eltradec/SCSI2SD-Mod/creator/readme

The BUILD command takes around 1-2 minutes to execute, it finishes with 4 warnings and the message below.
Der BUILD Befehl braucht etwa 1-2 Minuten zur Ausführung, er endet mit 4 Warnungen und der folgenden Meldung.

Flash used: 88334 of 262144 bytes (33,7%). Bootloader: 17152 bytes. Application: 70926 bytes. Metadata: 256 bytes.
SRAM used: 23589 of 65536 bytes (36,0%). Stack: 4096 bytes. Heap: 1024 bytes.

Sound output is generated by interrupts. The source code for the interrupt service routine is contained in the Generated_Source folder.
You need to build your project first, replace SOUND_ISR.c and SOUND_ISR.h by the files contained here in Generated_Source folder and rebuild.
Special instructions prevent PSoC Creator from overwriting these modified files.
Die Tonausgabe ist interruptgesteuert. Der Quellcode für die Interruproutine befindet sich im Ordner Generated_Source.
Sie sollten zuerst das Projekt normal kompilieren (BUILD), die generierten SOUND_ISR.c und SOUND_ISR.h durch die beiden gleichnamigen Files aus dem Ordner Generated_Source hier auf Github ersetzen und nochmals kompilieren (BUILD).
Spezielle Befehle verhindern, dass PSoC Creator diese modifizierten Files überschreibt.
