eltradec/SCSI2SD-Mod/kicad/scsi2sdkit11.pdf

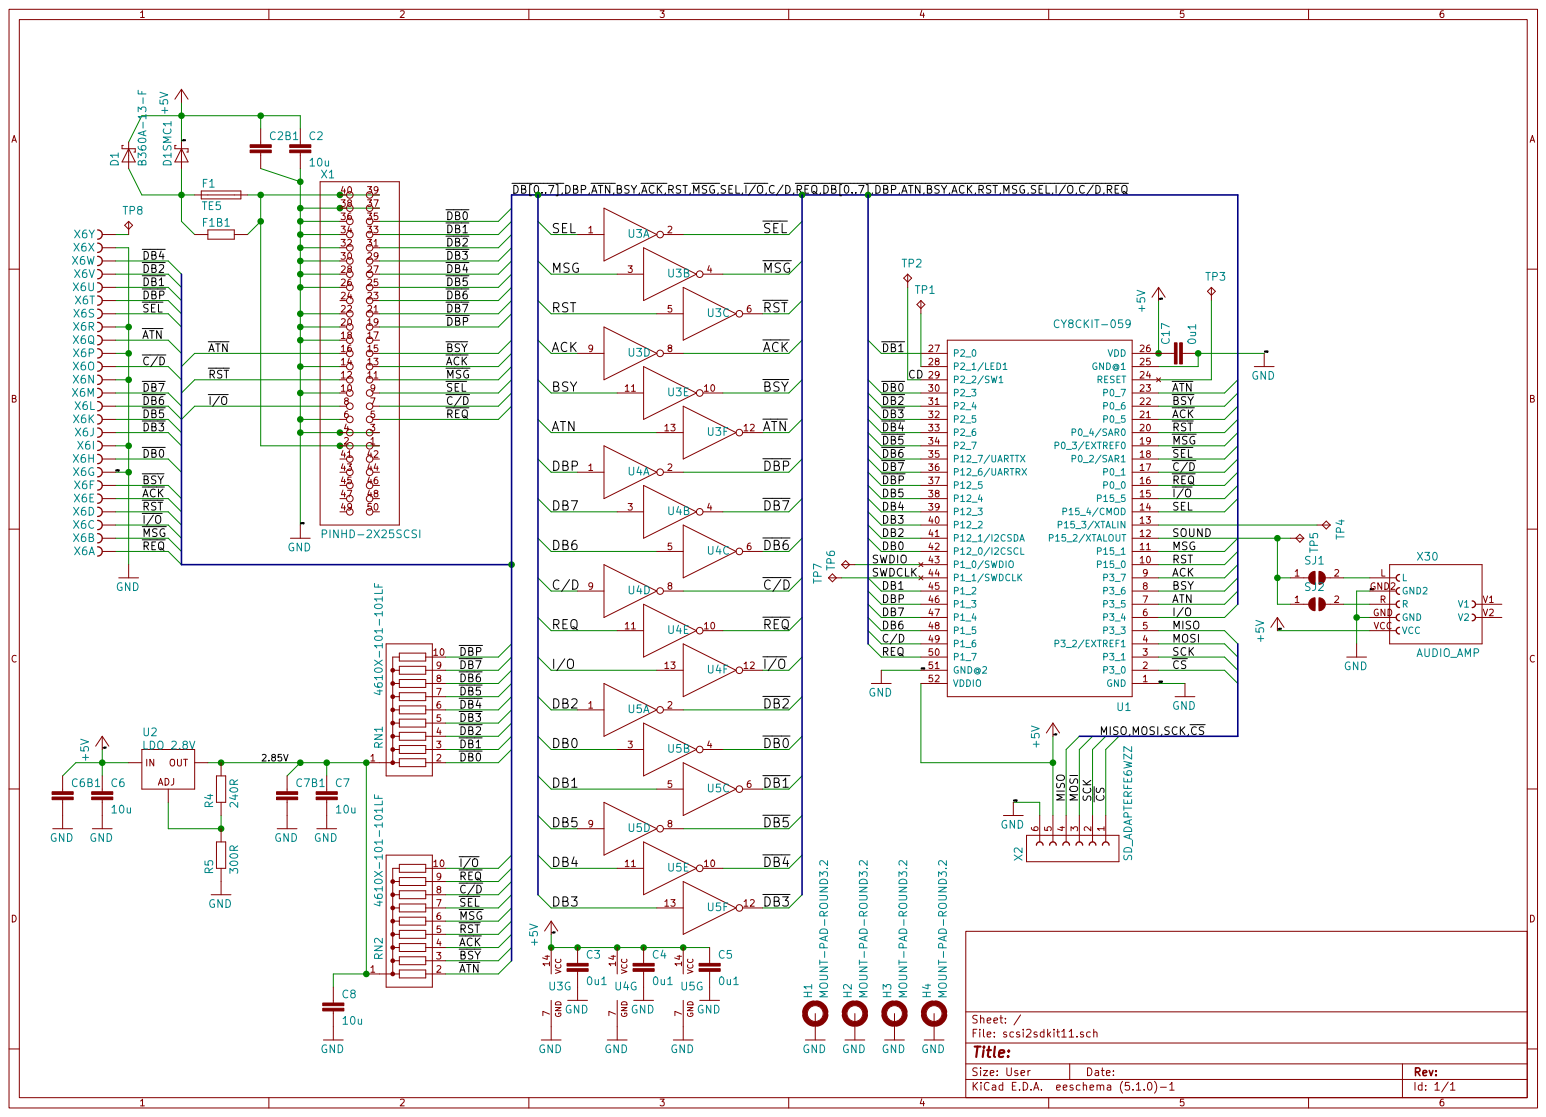
[picture p4: page 1]

DB[0..7],DBP,ATN,BSY,ACK,RST,MSG,SEL,I/O,C/D,REQ,DB[0..7],DBP,ATN,BSY,ACK,RST,MSG,SEL,I/O,C/D,REQ

MISO,MOSI,SCK,CS

Id: 1/1 Title: File: scsi2sdkit11.sch Sheet: /
