eltradec/SCSI2SD-Mod/kicad/scsi2sdkit10.sch

## KiCad design kicad/scsi2sdkit10.sch (2019-03-16)

Schematic: scsi2sdkit10.sch

Parts:
C2, C6, C7, C8: 10u; C1206K
C2B, C6B, C7B: C-EUC0805K; C0805K
C3, C4, C5, C17: 0u1; C0805K
D1: B360A-13-F; DO214AC
D1SMC: SCHOTTKY-DIODESMC; SMC
F1: TE5
F1B1: MF-NSMF150-2; R1206
H1, H2, H3, H4: MOUNT-PAD-ROUND3.2; 3,2-PAD
R4: 240R; M0805
R5: 300R; M0805
RN1, RN2: 4610X-101-101LF; SIL10
SJ1, SJ2: SJ
TP1, TP2, TP3, TP4, TP5, TP6, TP7, TP8: TPTP20R; TP20R
U1: CY8CKIT-059; DIL52
U2: LDO 2.8V; DPACK
U3, U4, U5: 7406D; SO14
X1: PINHD-2X25SCSI; 57102-F08-25THINTOP
X2: SD_ADAPTERFE6WZZ; FE06WZZ
X6: D-SUB25; H2M25ST_WO_HOLES
X30: AUDIO_AMP
