eltradec/SCSI2SD-Mod/src/main.c

//	Copyright (C) 2014 Michael McMaster <michael@codesrc.com>
//	Modified 2018 (or timestamp yymmdd) Robert Matyschok <rm@eltradec.eu), modifications commented with "RM" prefix
//
//	This file is part of SCSI2SD.
//
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
#include "device.h"
#include "scsi.h"
#include "scsiPhy.h"
#include "config.h"
#include "disk.h"
#include "led.h"
#include "SOUND_ISR.h"
#include "time.h"
#include "trace.h"
#include "VDAC8_1.h"

const char* Notice = "Copyright (C) 2015-2018 Michael McMaster <michael@codesrc.com>";
    
void soundInit()
{  
    // Opamp_1_Start(); // RM Opamp not present in CY8C52
    VDAC8_1_Start(); // RM start VDAC
    LPF_1_Start(); // RM start LPF
    PGA_1_Start(); // RM start PGA
    SOUND_ISR_Start(); // RM start sound
}

int main()
{
	timeInit();
	ledInit();
    soundInit(); // RM
	traceInit();

	// Enable global interrupts.
	// Needed for RST and ATN interrupt handlers.
	CyGlobalIntEnable;

	// Set interrupt handlers.
	scsiPhyInit();

	configInit(&scsiDev.boardCfg);
	debugInit();
    scsiPhyConfig();
	scsiInit();
	scsiDiskInit();

	// Optional bootup delay
	int delaySeconds = 0;
	while (delaySeconds < scsiDev.boardCfg.startupDelay) {
		// Keep the USB connection working, otherwise it's very hard to revert
		// silly extra-long startup delay settings.
		int i;
		for (i = 0; i < 200; i++) {
			CyDelay(5);
			scsiDev.watchdogTick++;
			configPoll();
		}
		++delaySeconds;
	}

	uint32_t lastSDPoll = getTime_ms();
	sdCheckPresent();

	while (1)
	{
		scsiDev.watchdogTick++;

		scsiPoll();
		scsiDiskPoll();
		configPoll();
		sdPoll();

		if (unlikely(scsiDev.phase == BUS_FREE))
		{
			if (unlikely(elapsedTime_ms(lastSDPoll) > 200))
			{
				lastSDPoll = getTime_ms();
				sdCheckPresent();
			}
			else
			{
				// Wait for our 1ms timer to save some power.
				// There's an interrupt on the SEL signal to ensure we respond
				// quickly to any SCSI commands. The selection abort time is
				// only 250us, and new SCSI-3 controllers time-out very
				// not long after that, so we need to ensure we wake up quickly.
				uint8_t interruptState = CyEnterCriticalSection();
				if (!SCSI_ReadFilt(SCSI_Filt_SEL))
				{
					__WFI(); // Will wake on interrupt, regardless of mask
				}
				CyExitCriticalSection(interruptState);
			}
		}
		else if ((scsiDev.phase >= 0) && (blockDev.state & DISK_PRESENT))
		{
			// don't waste time scanning SD cards while we're doing disk IO
			lastSDPoll = getTime_ms();
		}
	}
	return 0;
}
