eltradec/SCSI2SD-Mod/src/sound8.h

#define SAMPLES 15200
#define SAMPLE_RATE 8000
#define spinupstart 0
#define spinupstop 11999
#define spinning 6000
static volatile uint16_t sampleindex = 0;
const uint8_t data[SAMPLES] = {
140, 131, 131, 136, 132, 131, 125, 114, 
123, 130, 122, 132, 130, 127, 124, 121, 
126, 133, 136, 139, 138, 123, 117, 114, 
124, 122, 113, 123, 123, 134, 133, 137, 
138, 128, 134, 130, 128, 127, 121, 128, 
141, 125, 120, 118, 101, 121, 138, 140, 
160, 141, 141, 132, 114, 115, 108, 111, 
120, 133, 144, 144, 126, 129, 111, 113, 
126, 134, 153, 143, 143, 133, 114, 98, 
100, 99, 105, 139, 146, 161, 153, 132, 
126, 109, 114, 116, 116, 136, 149, 145, 
140, 121, 104, 96, 106, 123, 144, 162, 
161, 161, 137, 119, 103, 88, 104, 121, 
143, 155, 155, 140, 122, 119, 114, 112, 
120, 130, 131, 145, 141, 130, 105, 93, 
112, 121, 139, 147, 146, 141, 130, 126, 
112, 98, 111, 126, 127, 132, 137, 120, 
137, 132, 132, 139, 119, 141, 137, 133, 
138, 122, 104, 112, 120, 132, 139, 140, 
140, 136, 145, 129, 128, 127, 122, 122, 
123, 114, 110, 115, 120, 131, 131, 142, 
140, 134, 129, 118, 118, 123, 119, 131, 
126, 121, 135, 116, 118, 114, 123, 138, 
148, 158, 150, 143, 128, 111, 105, 112, 
113, 128, 142, 141, 153, 140, 134, 127, 
119, 119, 110, 125, 118, 132, 130, 122, 
120, 101, 112, 127, 138, 141, 148, 139, 
138, 133, 129, 115, 98, 102, 106, 121, 
144, 151, 154, 151, 137, 131, 122, 122, 
114, 118, 121, 127, 135, 139, 139, 115, 
127, 129, 128, 140, 143, 147, 128, 112, 
112, 100, 100, 107, 112, 128, 134, 148, 
153, 142, 135, 131, 122, 122, 122, 128, 
117, 120, 125, 122, 130, 125, 149, 130, 
147, 148, 137, 141, 118, 117, 105, 109, 
107, 119, 120, 137, 154, 139, 146, 140, 
115, 125, 107, 109, 130, 119, 129, 124, 
126, 130, 124, 127, 128, 126, 147, 143, 
153, 133, 104, 110, 100, 107, 116, 139, 
141, 136, 156, 154, 139, 125, 118, 108, 
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
    
125, 158, 173, 162, 160, 116, 96, 103, 
69, 118, 117, 145, 158, 158, 155, 120, 
115, 97, 112, 106, 128, 146, 134, 154, 
159, 128, 143, 96, 97, 133, 95, 142, 
141, 152, 144, 128, 132, 133, 104, 113, 
110, 107, 136, 125, 161, 169, 129, 123, 
129, 69, 108, 91, 112, 158, 142, 163, 
139, 118, 102, 98, 93, 126, 131, 160, 
163, 132, 154, 138, 113, 117, 93, 98, 
138, 139, 161, 166, 152, 121, 91, 92, 
96, 123, 121, 146, 150, 141, 142, 120, 
129, 100, 118, 110, 128, 132, 135, 159, 
126, 144, 116, 119, 119, 109, 122, 135, 
126, 149, 142, 115, 126, 101, 114, 132, 
126, 128, 145, 104, 149, 138, 129, 170, 
128, 133, 123, 104, 107, 109, 114, 144, 
127, 147, 145, 117, 120, 106, 111, 99, 
131, 125, 172, 147, 134, 155, 95, 124, 
95, 101, 123, 132, 148, 156, 146, 135, 
109, 103, 100, 105, 118, 144, 154, 134, 
176, 150, 134, 113, 103, 98, 97, 129, 
149, 159, 145, 131, 129, 98, 91, 96, 
105, 139, 141, 162, 162, 143, 132, 127, 
89, 106, 104, 125, 146, 131, 156, 125, 
125, 97, 108, 116, 118, 132, 134, 147, 
131, 139, 144, 120, 124, 131, 107, 132, 
129, 128, 130, 121, 130, 142, 132, 124, 
123, 109, 103, 106, 132, 151, 166, 152, 
147, 124, 106, 103, 115, 109, 130, 146, 
143, 158, 129, 120, 96, 93, 102, 119, 
140, 153, 143, 147, 138, 113, 97, 89, 
90, 127, 142, 148, 195, 156, 131, 107, 
97, 99, 91, 124, 154, 158, 167, 149, 
133, 117, 85, 103, 104, 129, 128, 149, 
175, 137, 145, 132, 109, 104, 92, 110, 
142, 131, 145, 150, 127, 123, 111, 104, 
98, 107, 123, 150, 137, 126, 151, 124, 
121, 133, 128, 129, 113, 135, 136, 127, 
141, 117, 136, 114, 94, 128, 139, 144, 
141, 130, 130, 118, 111, 157, 120, 130, 
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
};
