eltradec/SCSI2SD-Mod/src/diagnostic.c

//	Copyright (C) 2013 Michael McMaster <michael@codesrc.com>
//
//	This file is part of SCSI2SD.
//
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
#include "device.h"
#include "scsi.h"
#include "diagnostic.h"

#include <string.h>

static const uint8 SupportedDiagnosticPages[] =
{
0x00, // Page Code
0x00, // Reserved
0x02, // Page length
0x00, // Support "Supported diagnostic page"
0x40  // Support "Translate address page"
};

void scsiSendDiagnostic()
{
	// SEND DIAGNOSTIC
	// Pretend to do self-test. Actual data is returned via the
	// RECEIVE DIAGNOSTIC RESULTS command.
	int selfTest = scsiDev.cdb[1] & 0x04;
	uint32 paramLength =
		(((uint32) scsiDev.cdb[3]) << 8) +
		scsiDev.cdb[4];

	if (!selfTest)
	{
		// Initiator sends us page data.
		scsiDev.dataLen = paramLength;
		scsiDev.phase = DATA_OUT;

		if (scsiDev.dataLen > sizeof (scsiDev.data))
		{
			// Nowhere to store this data!
			// Shouldn't happen - our buffer should be many magnitudes larger
			// than the required size for diagnostic parameters.
			scsiDev.target->sense.code = ILLEGAL_REQUEST;
			scsiDev.target->sense.asc = INVALID_FIELD_IN_CDB;
			scsiDev.status = CHECK_CONDITION;
			scsiDev.phase = STATUS;
		}
	}
	else
	{
		// Default command result will be a status of GOOD anyway.
	}
}

void scsiReceiveDiagnostic()
{
	// RECEIVE DIAGNOSTIC RESULTS
	// We assume scsiDev.data contains the contents of a previous
	// SEND DIAGNOSTICS command.  We only care about the page-code part
	// of the parameter list.
	uint8 pageCode = scsiDev.data[0];

	int allocLength =
		(((uint16) scsiDev.cdb[3]) << 8) +
		scsiDev.cdb[4];


	if (pageCode == 0x00)
	{
		memcpy(
			scsiDev.data,
			SupportedDiagnosticPages,
			sizeof(SupportedDiagnosticPages));
		scsiDev.dataLen = sizeof(SupportedDiagnosticPages);
		scsiDev.phase = DATA_IN;
	}
	else if (pageCode == 0x40)
	{
		// Translate between logical block address, physical sector address, or
		// physical bytes.
		uint8 suppliedFmt = scsiDev.data[4] & 0x7;
		uint8 translateFmt = scsiDev.data[5] & 0x7;

		// Convert each supplied address back to a simple
		// 64bit linear address, then convert back again.
		uint64 fromByteAddr =
			scsiByteAddress(
				scsiDev.target->liveCfg.bytesPerSector,
				scsiDev.target->cfg->headsPerCylinder,
				scsiDev.target->cfg->sectorsPerTrack,
				suppliedFmt,
				&scsiDev.data[6]);

		scsiSaveByteAddress(
			scsiDev.target->liveCfg.bytesPerSector,
			scsiDev.target->cfg->headsPerCylinder,
			scsiDev.target->cfg->sectorsPerTrack,
			translateFmt,
			fromByteAddr,
			&scsiDev.data[6]);

		// Fill out the rest of the response.
		// (Clear out any optional bits).
		scsiDev.data[4] = suppliedFmt;
		scsiDev.data[5] = translateFmt;

		scsiDev.dataLen = 14;
		scsiDev.phase = DATA_IN;
	}
	else
	{
		// error.
		scsiDev.status = CHECK_CONDITION;
		scsiDev.target->sense.code = ILLEGAL_REQUEST;
		scsiDev.target->sense.asc = INVALID_FIELD_IN_CDB;
		scsiDev.phase = STATUS;
	}

	if (scsiDev.phase == DATA_IN && scsiDev.dataLen > allocLength)
	{
		// simply truncate the response.
		scsiDev.dataLen = allocLength;
	}

	{
		// Set the first byte to indicate LUN presence.
		if (scsiDev.lun) // We only support lun 0
		{
			scsiDev.data[0] = 0x7F;
		}
	}
}

void scsiReadBuffer()
{
	// READ BUFFER
	// Used for testing the speed of the SCSI interface.
	uint8 mode = scsiDev.data[1] & 7;

	int allocLength =
		(((uint32) scsiDev.cdb[6]) << 16) +
		(((uint32) scsiDev.cdb[7]) << 8) +
		scsiDev.cdb[8];

	if (mode == 0)
	{
		uint32_t maxSize = MAX_SECTOR_SIZE - 4;
		// 4 byte header
		scsiDev.data[0] = 0;
		scsiDev.data[1] = (maxSize >> 16) & 0xff;
		scsiDev.data[2] = (maxSize >> 8) & 0xff;
		scsiDev.data[3] = maxSize & 0xff;

		scsiDev.dataLen =
			(allocLength > MAX_SECTOR_SIZE) ? MAX_SECTOR_SIZE : allocLength;
		scsiDev.phase = DATA_IN;
	}
	else
	{
		// error.
		scsiDev.status = CHECK_CONDITION;
		scsiDev.target->sense.code = ILLEGAL_REQUEST;
		scsiDev.target->sense.asc = INVALID_FIELD_IN_CDB;
		scsiDev.phase = STATUS;
	}
}

// Callback after the DATA OUT phase is complete.
static void doWriteBuffer(void)
{
	if (scsiDev.status == GOOD) // skip if we've already encountered an error
	{
		// scsiDev.dataLen bytes are in scsiDev.data
		// Don't shift it down 4 bytes ... this space is taken by
		// the read buffer header anyway
		scsiDev.phase = STATUS;
	}
}

void scsiWriteBuffer()
{
	// WRITE BUFFER
	// Used for testing the speed of the SCSI interface.
	uint8 mode = scsiDev.data[1] & 7;

	int allocLength =
		(((uint32) scsiDev.cdb[6]) << 16) +
		(((uint32) scsiDev.cdb[7]) << 8) +
		scsiDev.cdb[8];

	if (mode == 0 && allocLength <= sizeof(scsiDev.data))
	{
		scsiDev.dataLen = allocLength;
		scsiDev.phase = DATA_OUT;
		scsiDev.postDataOutHook = doWriteBuffer;
	}
	else
	{
		// error.
		scsiDev.status = CHECK_CONDITION;
		scsiDev.target->sense.code = ILLEGAL_REQUEST;
		scsiDev.target->sense.asc = INVALID_FIELD_IN_CDB;
		scsiDev.phase = STATUS;
	}
}

// XEBEC specific command. See 
// http://www.bitsavers.org/pdf/westernDigital/WD100x/79-000004_WD1002-SHD_OEM_Manual_Aug1984.pdf
// Section 4.3.14
void scsiWriteSectorBuffer()
{
       scsiDev.dataLen = scsiDev.target->liveCfg.bytesPerSector;
       scsiDev.phase = DATA_OUT;
       scsiDev.postDataOutHook = doWriteBuffer;
}
